cedric-carels/Line-Following-Robot/README.md

# Line-Following-Robot

Een zelfrijdende wagen moet een parcours volgen. Deze route is door middel 
van een witte lijn op de grond vastgelegd.

Indien de wagen aan een witte dwarslijn komt, moet de wagen stoppen.

Indien de bestuurder op een drukknop drukt, rijdt de wagen verder. Indien de 
bestuurder niet op de drukknop drukt, zal de wagen na 5 minuten toch verder 
rijden. Omdat het project op kleine schaal is gebouwd, is de tijd verkort naar 5 
seconden.

De wagen mag niet botsen met een voorligger. Er moet 1,5 meter afstand zijn 
tussen de wagens. Omdat het project op kleine schaal is gebouwd, is de 
afstand verkort naar 20 centimeter.

De wagens moeten ook van leds voorzien zijn zodat men kan zien in welke 
modus de wagen zich bevindt :
- Groene led : alles verloopt correct
- Blauwe led : de wagen is gestopt voor een dwarsstreep of voor een voorliggende auto
- Rode led : de wagen is van het parcours geweken

## Dit document geeft een beknopte omschrijving van :
- De hardware die nodig is om dit project te kunnen maken
- Hoe de hardware in elkaar wordt gezet
- De code(s) die je nodig hebt om dit project te kunnen laten werken
