cedric-carels/Line-Following-Robot/2. Programmatie/README.md

# Wat vind je terug in deze folders:

In de folder "**Hoofdcode**" vind je de volledige code terug van het project voor tracking
met witte lijn en tracking met zwarte lijn.
- Iot_Project_blackline
- Iot_Project_whiteline

In de folder "**Subcode**" zitten de aparte codes voor de werking van de verschillende 
onderdelen apart.
Het gaat om volgende bestanden :
- RGB_analogWrite
- RGB_digitalWrite
- button
- motor
- object_decteren
- tracking_sensor
- tracking_sensor_button_RGB
