cedric-carels/Line-Following-Robot/3. Presentatie/Line Following Robot.pdf

Carels Cédric
31.05.2021

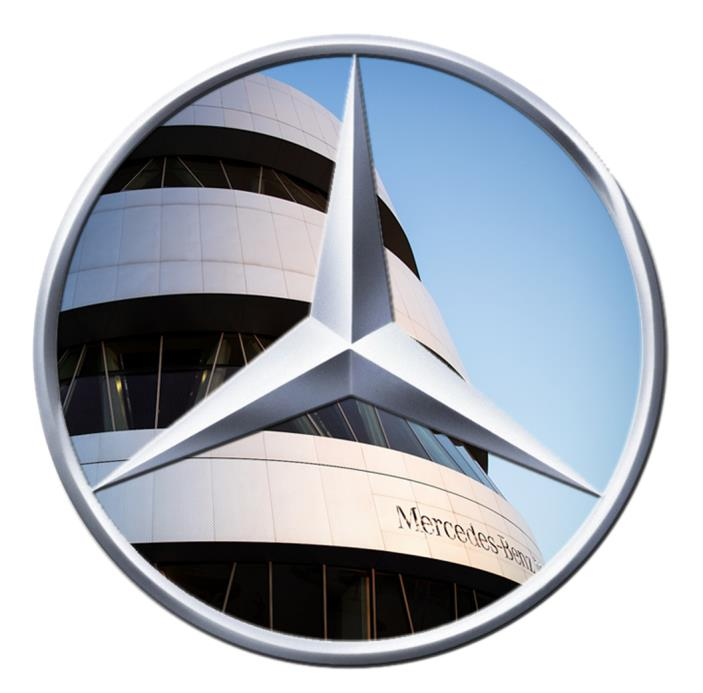
[picture p1: figure]

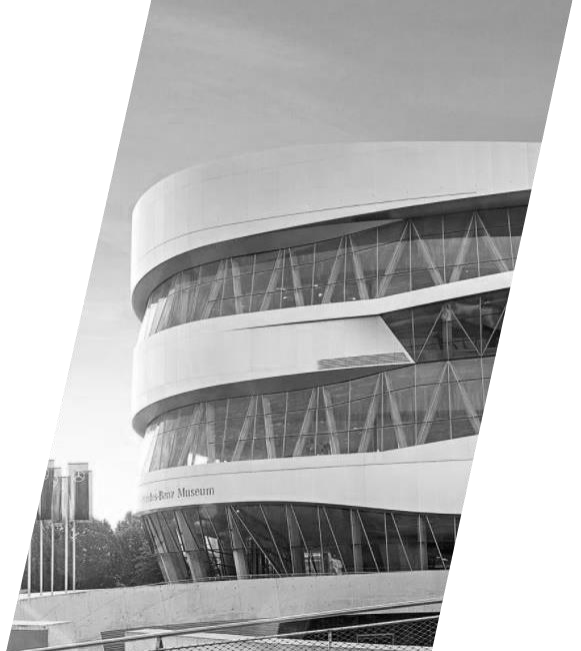
[picture p2: figure]

# PRESENTATIE

D O E L S T E L L I N G E N

O N D E R D E L E N

V O O R D E L E N

V O O R S T E L L I N G P R O J E C T

V R A G E N

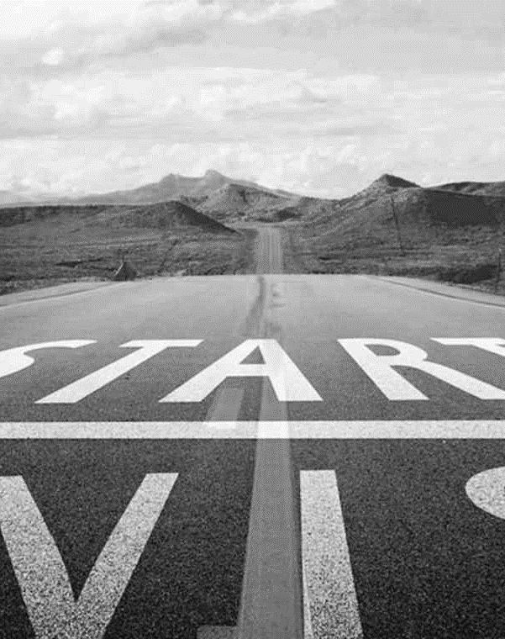
[picture p3: figure]

### DOELSTELLINGEN

- Volgen van een parcours
- Bij dwarslijn stoppen
- Doorrijden na 5 seconden
- Doorrijden bij drukken op knop
- Objectdetectie om botsing te voorkomen
- Controle status door leds
- Groene led
- Blauwe led
- Rode led

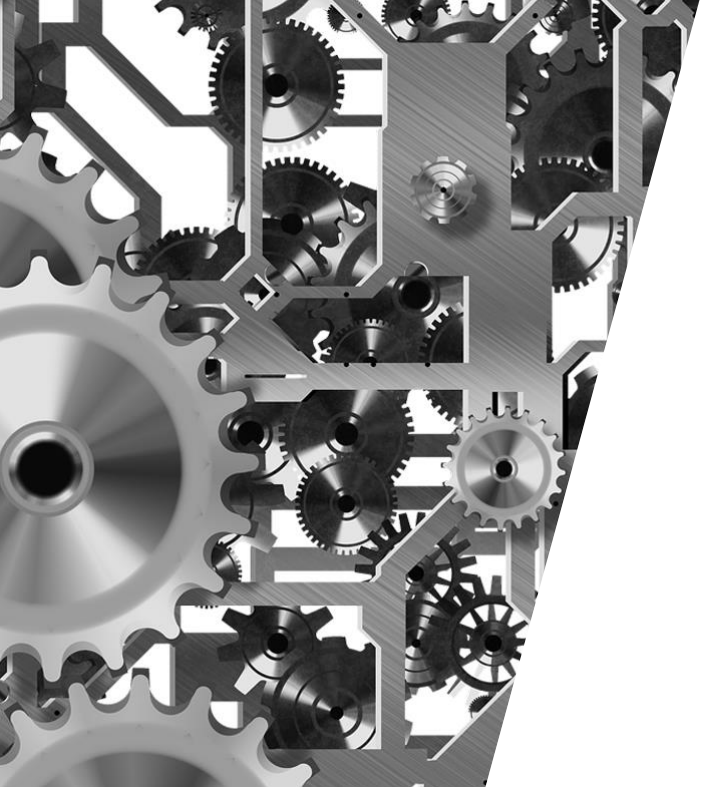
[picture p4: figure]

# ONDERDELEN

4

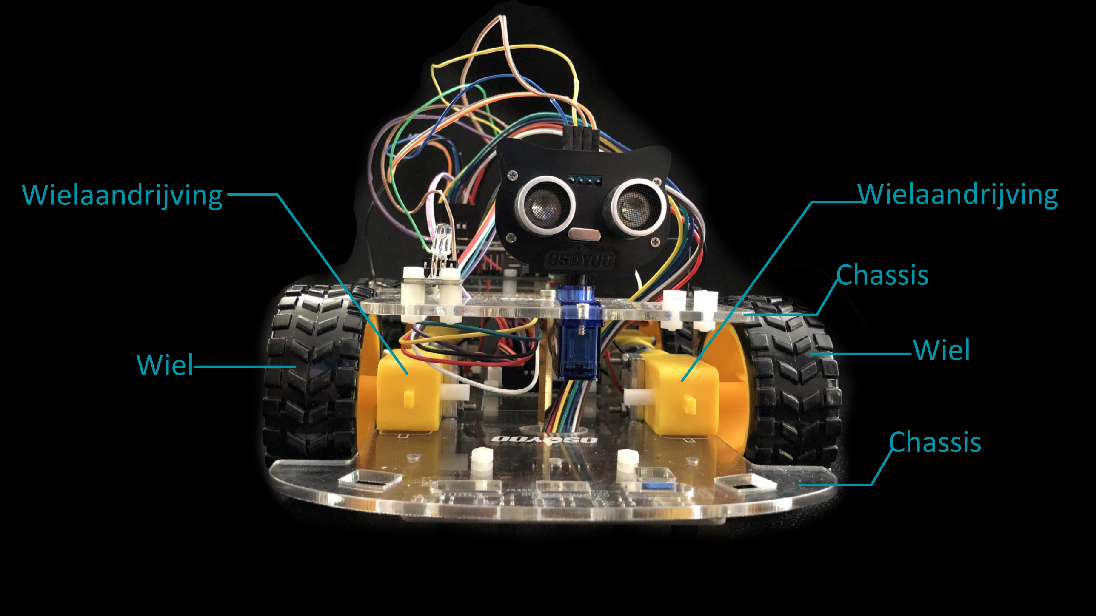
[picture p5: page 5]

Wielaandrijving

Chassis

Chassis

Wiel | Wiel Wielaandrijving

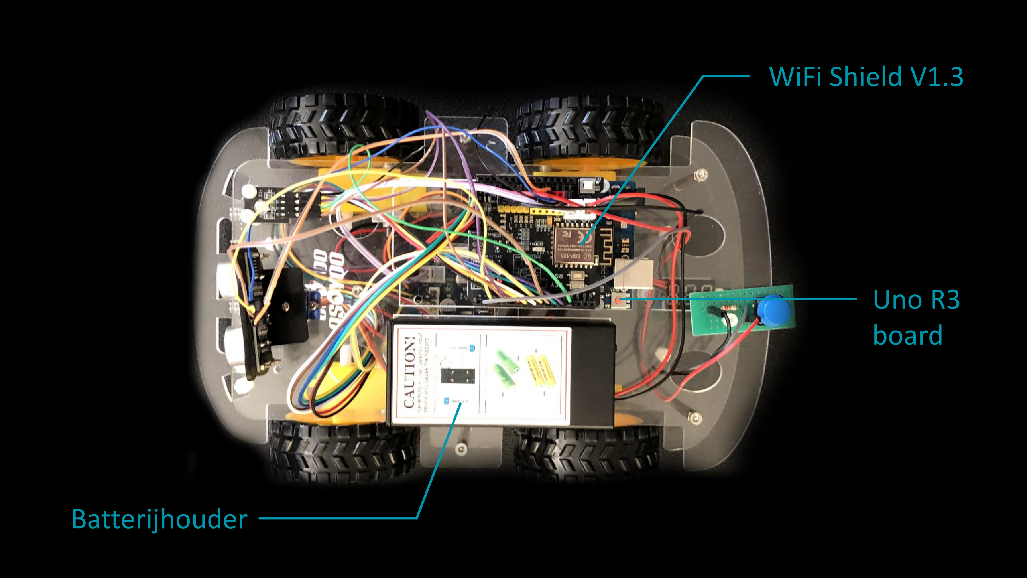
[picture p6: page 6]

Batterijhouder

Uno R3
board

WiFi Shield V1.3

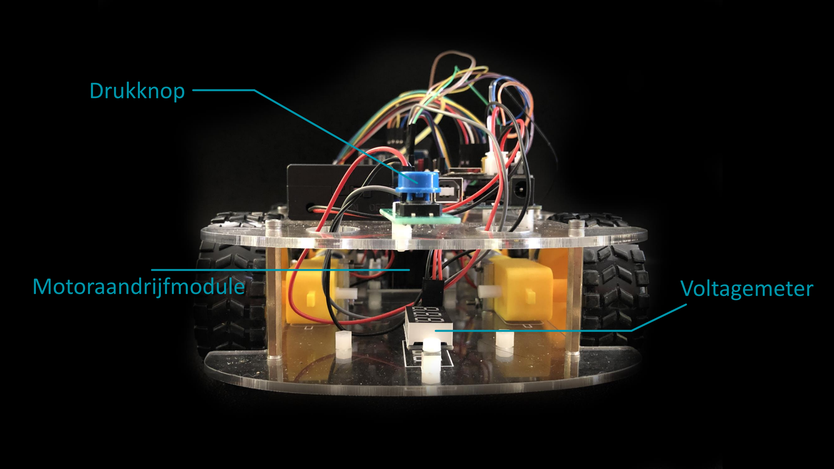
[picture p7: page 7]

Drukknop

Motoraandrijfmodule | Voltagemeter

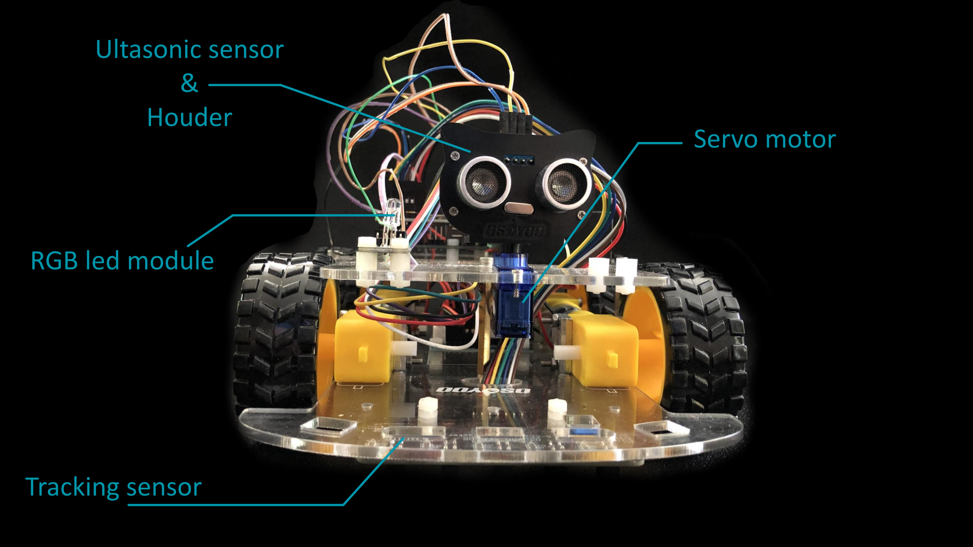
[picture p8: page 8]

Ultasonic sensor
&
Houder

RGB led module

Tracking sensor

Servo motor

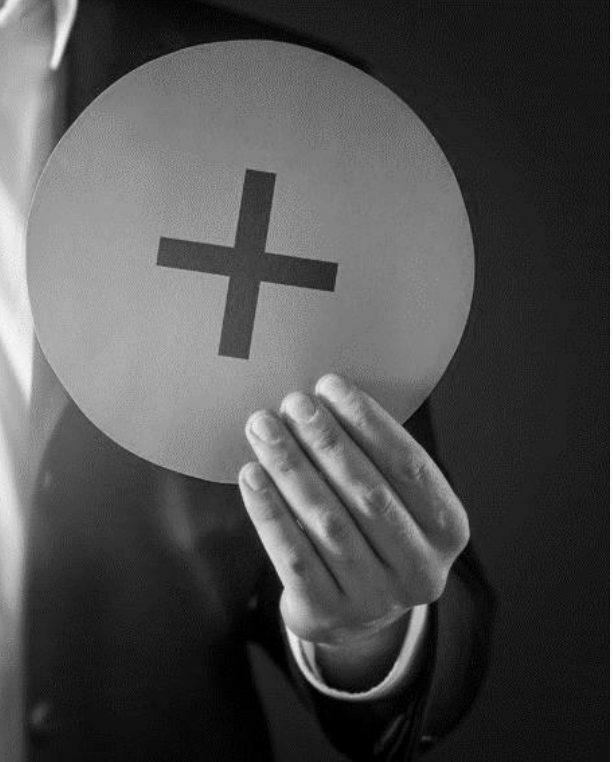
[picture p9: figure]

### VOORDELEN

- Parcours kan uitgebreid en veranderd worden
- Stoppunten gemakkelijk aan te passen
- Kleur lijn kan ook zwart
- Uitbreiding controle via WiFi
- Snelheid gemakkelijk aan te passen
- Stoptijd gemakkelijk aan te passen
- Bochten : scherper of minder scherp
- Extra onderdelen bijvoegen :
- buzzer
- schermen

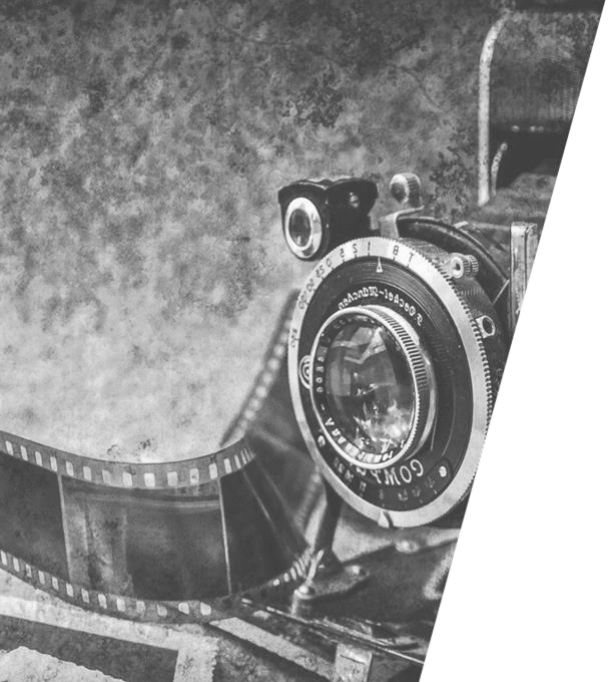
[picture p10: figure]

# VOORSTELLING PROJECT

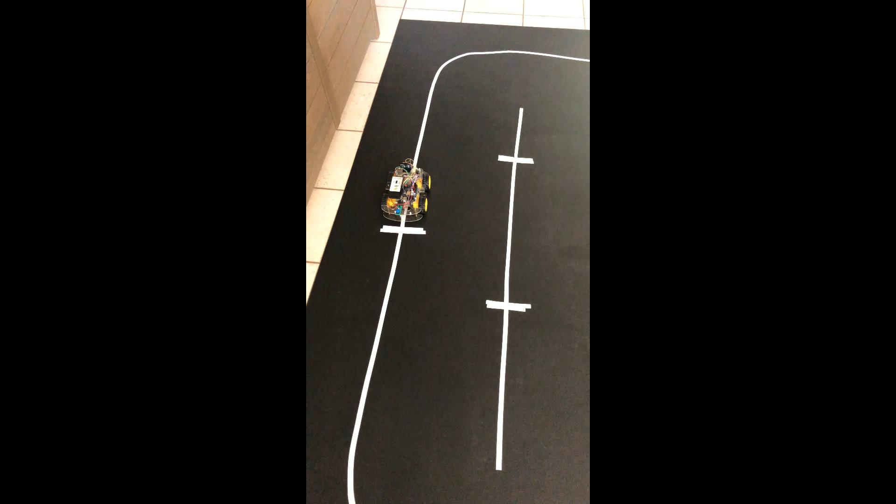
[picture p11: page 11]

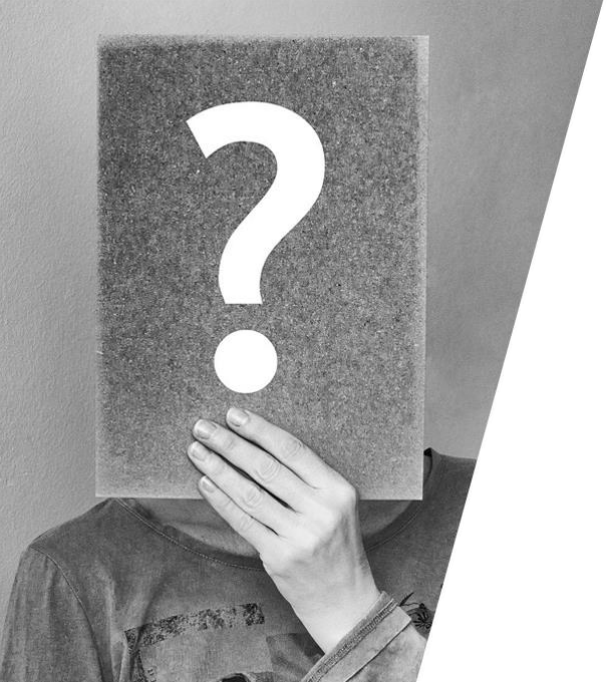
[picture p12: figure]

# VRAGEN
